abcuer/2024-NUEDC-H-TI_CAR/README.md

# 🚗 惯性导航+巡线自动行驶小车 -24电赛H题
## 完赛实测：任务四总用时35秒

## [bilibili视频演示](https://www.bilibili.com/video/BV1xQNzzUEWS/?spm_id_from=333.1387.homepage.video_card.click)
## [嘉立创EDA开源](https://u.lceda.cn/account/user/projects/index/members?project=a21ed0727ad447719ecbd93959d565b7&folder=all)

## 本项目基于 **TI MSPM0G3507** 微控制器开发，旨在通过 **JY901S 陀螺仪**、**电机编码器**以及 **8 路灰度传感器**的融合控制，实现小车在复杂赛道上的高精度定距、定向及巡线行驶。

---

## 🏎️ 核心算法逻辑 (Development Logic)

本项目采用**分层模块化**与**有限状态机 (FSM)** 的设计思想。

### 1. 基础动作原子 (Action Primitives)
我们将复杂的任务拆解为四个可重用的动作模块：
* **直行模式 (Gyro Straight)**：利用 JY901S 陀螺仪提供偏航角反馈，通过 `AnglePidCtrl` 实现偏航角闭环，确保在无引导区保持航向。
* **寻迹模式 (Line Tracking)**：采样 8 路灰度传感器数据，通过位置 PID 算法实时修正舵机/差速。
* **定距行驶 (Encoder Odometer)**：基于霍尔编码器数据进行物理位移积分，用于斜穿任务的里程控制。
* **节点触发 (Event Trigger)**：通过 `Line_flag` 状态切换和声光反馈（蜂鸣器+LED）确保节点到达的物理确认。

---

## 📋 任务实现说明 (Task Implementation)

### ■ 任务 1：定向直行与边界识别
* **控制链**：`记录初始角` -> `陀螺仪闭环直行` -> `灰度边缘检测` -> `刹停反馈`。
* **要点**：利用陀螺仪补偿机械结构不对称带来的跑偏问题。

### ■ 任务 2：混合模式循环 (S型/环形)
* **核心逻辑**：采用 **直行-寻迹-直行-寻迹** 的循环状态机。
* **切换机制**：通过 `line_flag` 实时捕捉黑线边界。进入黑线区自动切换为寻迹 PID，离开黑线区（检测到全白）立即切回角度闭环，解决弯道衔接处的失控风险。

### ■ 任务 3：非对称对角线穿越
* **运动模型**：`原地旋转` -> `定距行驶` -> `触线寻迹`。
* **技术细节**：预设 `angle3/angle4` 目标角，通过编码器记录里程。在到达预设距离后开始“探测”黑线，实现斜向切入巡线轨迹。

### ■ 任务 4：高速动态补偿循环
* **优化策略**：
    1.  **速度增益**：显著提升 `basespeed` 基准，并匹配高频响应 PID 参数。
    2.  **动态补偿表**：针对高速行驶下的物理惯性累积误差，通过查表法（Lookup Table）随圈数动态调整目标角度与里程。
    3.  **非阻塞执行**：全流程采用步进状态机，确保传感器采样频率不受逻辑延时干扰。

---

## 🛠️ 控制方案 (Control Schemes)

项目中集成了多套闭环控制系统：

| 控制环路 | 输入传感器 | 输出目标 | 核心作用 |
| :--- | :--- | :--- | :--- |
| **角度环 (Angle PID)** | JY901S (Yaw) | 左右电机差速 | 保持绝对航向，修正物理偏移 |
| **寻迹环 (Track PID)** | 8路灰度传感器 | 左右电机差速 | 拟合黑线中心偏差，精准巡线 |

---

## 🚀 性能优化亮点 (Optimization)

* **状态机解耦**：将 Task 3 与 Task 4 逻辑抽象化，通过同一个执行器管理，降低了维护难度。
* **查表法补偿**：在 Task 4 中使用数组管理每圈的修正值（角度、距离），调试时无需修改代码逻辑。
* **防御性编程**：引入 `TimeLimit` 超时保护与 `Task_Reset` 统一清理函数，增强系统健壮性。

---

## 💡 使用与调试建议
1.  **静态校准**：启动任务前请确保小车静止，以校准陀螺仪零位。
2.  **补偿微调**：若 Task 4 出现漂移，可直接修改 `task.c` 中的 `d_angle` 和 `d_dis` 补偿数组。
3.  **模式切换**：通过按键切换 `task_num` 后，按下启动键即可进入对应的状态机。

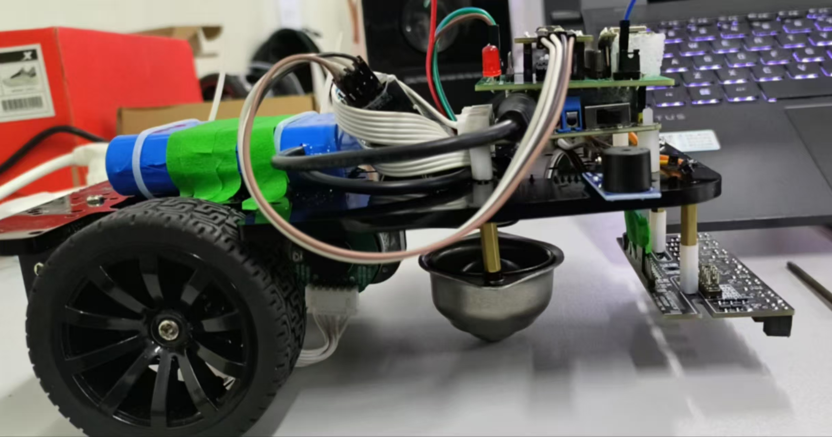
[picture p1: .doc/photo/d38a10215564251673b585ed0c2ac42.jpg]
d38a10215564251673b585ed0c2ac42

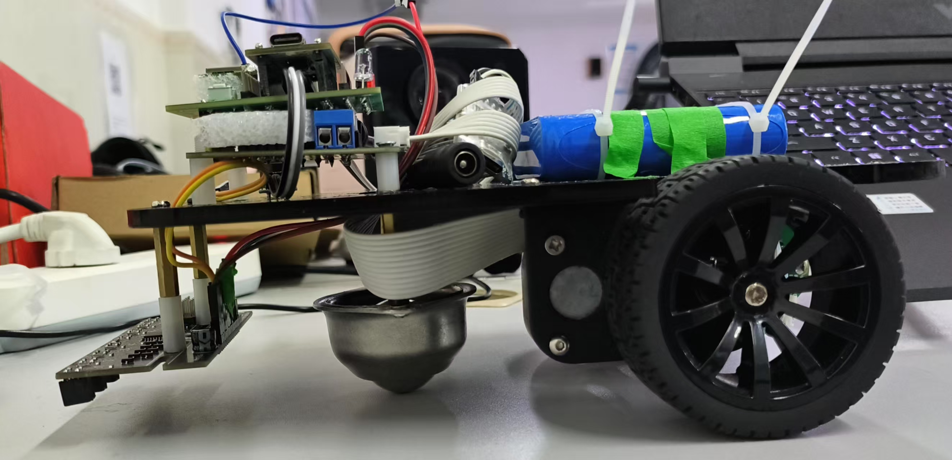
[picture p2: .doc/photo/cea49113ae89ae7cbaa048b8cb9e474.jpg]
cea49113ae89ae7cbaa048b8cb9e474

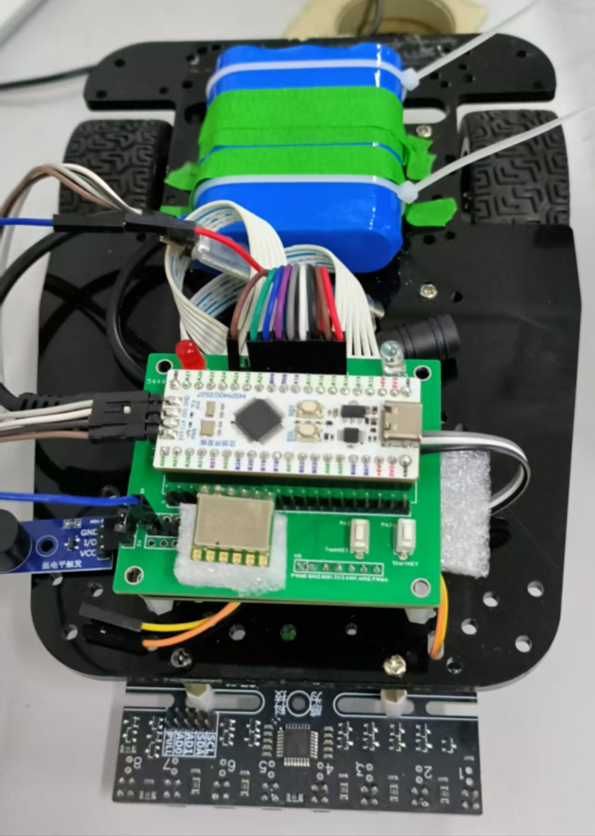
[picture p3: .doc/photo/55c712735c4f2a0491421d0f4ae0dd6.jpg]
55c712735c4f2a0491421d0f4ae0dd6

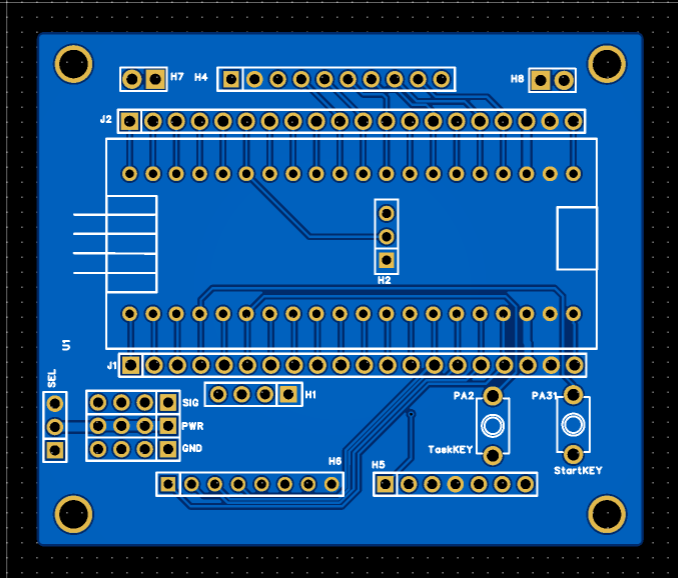
[picture p4: .doc/photo/image.jpg]
PCB正面


## <span style="background-color:#FF5733; color:white; padding:2px 6px; border-radius:3px;">电子模块</span>

- [立创地猛星MSPM0G3507主控板（电赛优惠价30块)](https://item.szlcsc.com/24478333.html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)
- [R3X系列三轮小车车模 106](https://item.taobao.com/item.htm?id=594481149003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)
- [MG513电机、13线霍尔编码器](https://item.taobao.com/item.htm?id=594481149003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)
- [塔克创新Tb6612电机驱动模块(带稳压) 32](https://detail.tmall.com/item.htm?id=838447196772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)
- [CY-25A不锈钢牛眼轮 3](https://detail.tmall.com/item.htm?id=920100840332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)
- [5mmLED灯 2](https://item.taobao.com/item.htm?id=674866929367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)
- [按键 2](https://item.taobao.com/item.htm?id=45677272349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)
- [有源蜂鸣器(低电平触发) 3](https://detail.tmall.com/item.htm?id=656159590251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)
- [JY901S陀螺仪 95](https://item.taobao.com/item.htm?id=634627673077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)
- [8路灰度传感器 75](https://item.taobao.com/item.htm?id=700000730878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)
- [12V锂电池 22](https://item.taobao.com/item.htm?id=562015429673)
