abcuer/2024-NUEDC-H-TI_CAR/(commit log)

2025-03-16 2024年TI杯H题
2025-03-18 参数优化
2025-03-18 perf👌: 提高性能和稳定性
2025-03-18 fix🐛:
2025-03-24 perf👌: 提高稳定性
2025-04-22 交叉寻迹，提速但稳定性差
2025-04-28 test✅: gray代码更新
2025-05-12 tune(pid): 调整 PID 参数和传感器配置
    - 修改了 distance.c 中的距离传感器值
    - 调整了 pid.c 中的 PID 控制参数
    - 更新了 task.c 中的任务逻辑和速度设置
    - 修改了 empty.c 中的 LED 控制逻辑
2025-05-14 稳定版本
2025-05-16 tag📌: 35s
2025-05-16 publish🚀: 35秒
2025-05-16 docs(README): 更新项目文档并移除冗余文件 - 更新 README.md，添加项目简介、电子模块列表和任务点
2025-05-17 docs(README): 更新项目文档和图片
2025-06-08 添加元器件购买链接
2025-06-17 docs(README): 更新Readme文档
2025-07-13 refactor(Code): 调整中断优先级 - 修改 TIMER1 的中断优先级为 1 - 更新 ti_msp_dl_config 中的 TIMER_0 中断优先级设置
2025-07-15 refactor🎨: 项目文件分层管理，使思路更清晰
2025-07-16 校准电机方向
2025-10-29 更新文档
2025-11-30 docs📝: 完善食用指南
2026-03-02 format🥚: 重构
2026-03-03 docs📝: 更新食用指南
2026-03-05 docs📝: 完善使用指南
2026-07-11 fix：更改左电机行驶方向
2026-07-11 fix: 更改左电机行驶方向
2026-07-11 perf: 使用宏定义规范速度，使代码更直观
